sebastienb/IphoneDuoCase/build/shellA_camera_half.stl

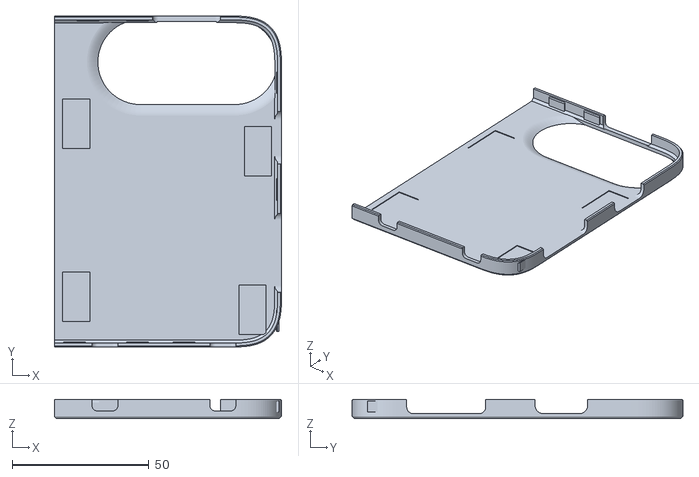
[picture p1: CAD file, 2026-11-08]
build/shellA_camera_half.stl
83.0 x 121.0 x 7.03
