sebastienb/IphoneDuoCase/build/shellB_display_half.stl

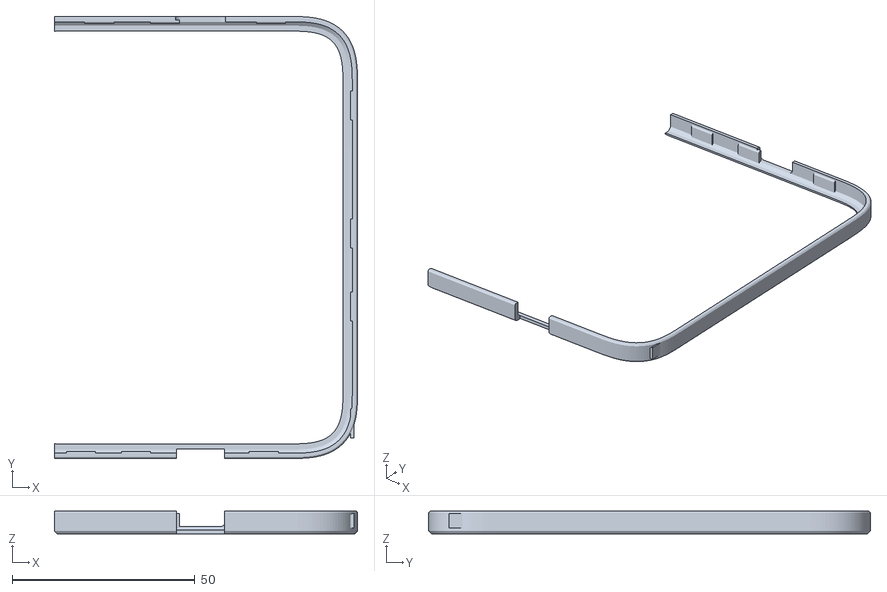
[picture p2: CAD file, 2026-11-08]
build/shellB_display_half.stl
83.0 x 121.0 x 6.23
