sebastienb/IphoneDuoCase/build/couponB_bottom.stl

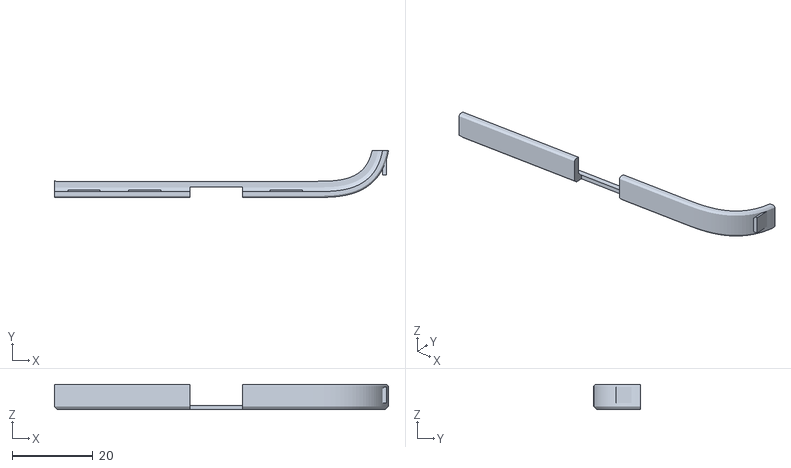
[picture p3: CAD file, 2026-11-08]
build/couponB_bottom.stl
82.6 x 11.6 x 6.23
