sebastienb/IphoneDuoCase/build/couponA_camera_top.stl

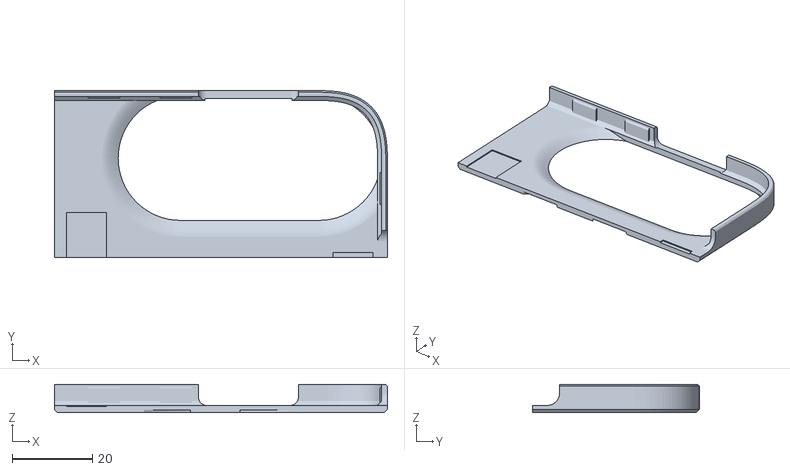
[picture p4: CAD file, 2026-11-08]
build/couponA_camera_top.stl
83.0 x 41.6 x 7.03
