sebastienb/IphoneDuoCase/build/couponA_bottom.stl

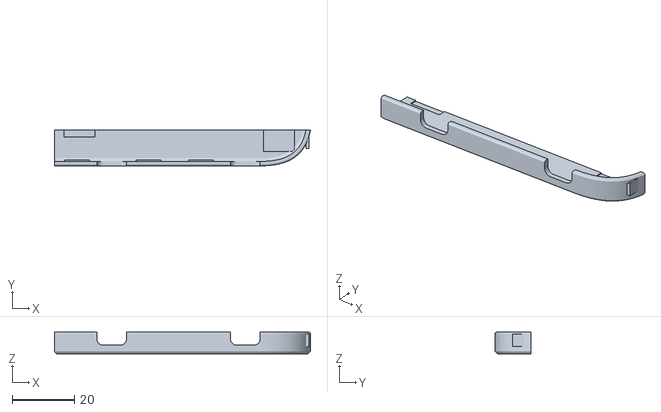
[picture p5: CAD file, 2026-11-08]
build/couponA_bottom.stl
82.6 x 11.6 x 7.03
