sebastienb/IphoneDuoCase/build/shellA_camera_collar.stl

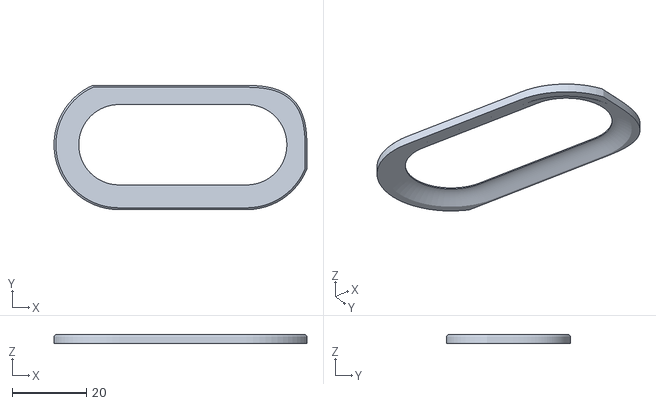
[picture p6: CAD file, 2026-11-08]
build/shellA_camera_collar.stl
68.4 x 33.6 x 2.44
