sebastienb/IphoneDuoCase/(list of files, cad)

Other CAD files:
build/duo_case.blend
