sebastienb/IphoneDuoCase/build/render_back.png

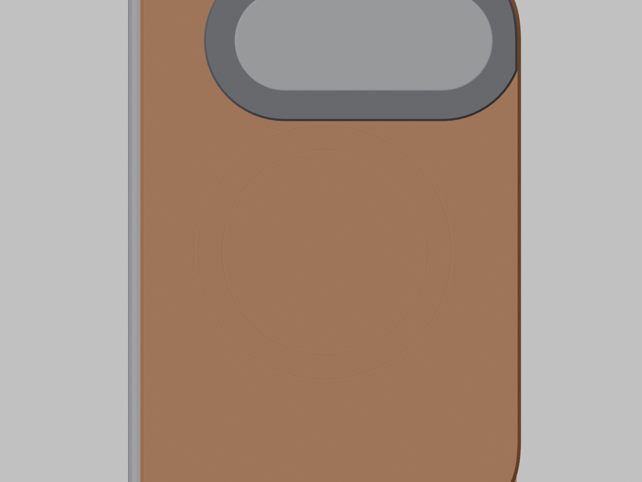
build/render_back.png
