sebastienb/IphoneDuoCase/build/render_camera_closeup.png

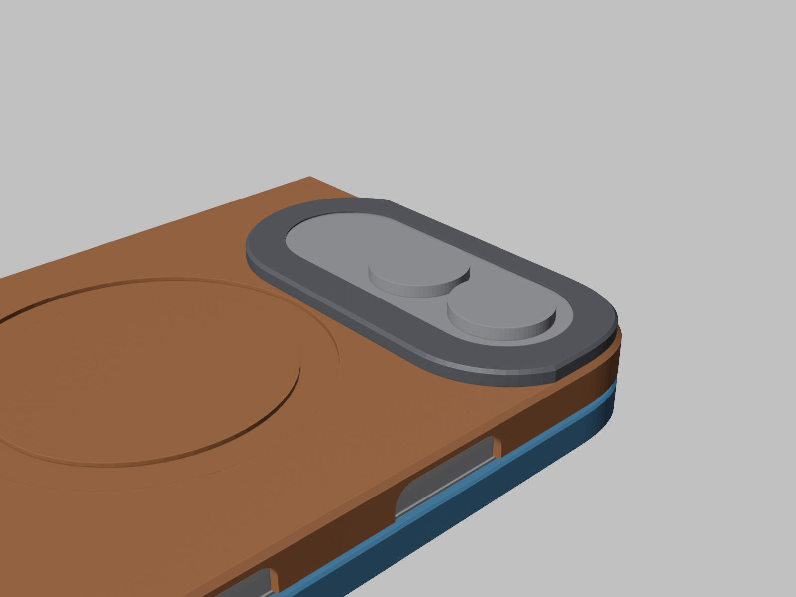
build/render_camera_closeup.png
