sebastienb/IphoneDuoCase/build/render_inside_A.png

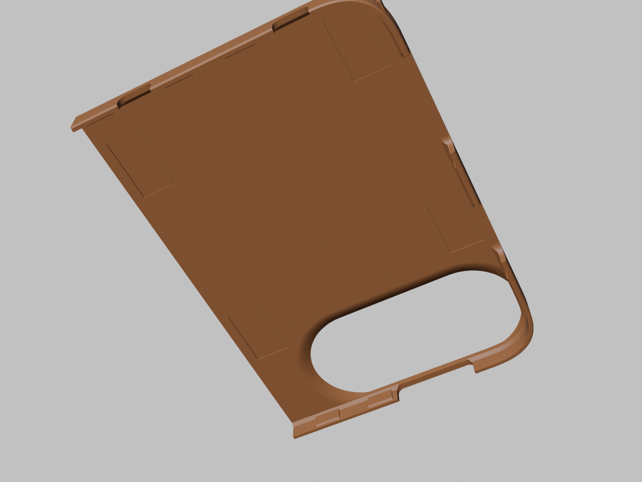
build/render_inside_A.png
