sebastienb/IphoneDuoCase/build/render_iso_back.png

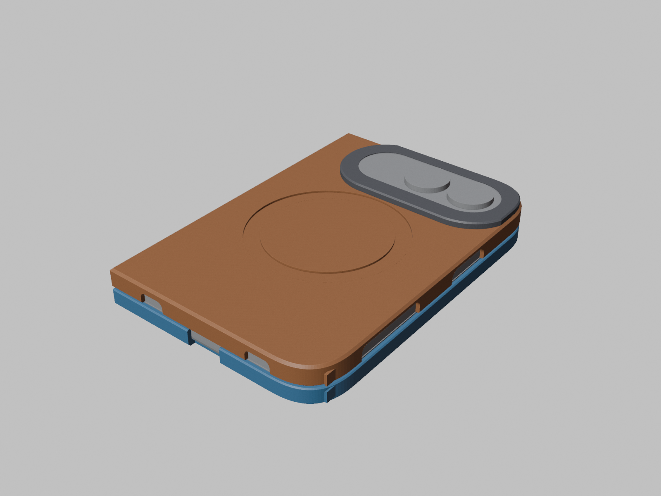
build/render_iso_back.png
