sebastienb/IphoneDuoCase/build/render_iso_front.png

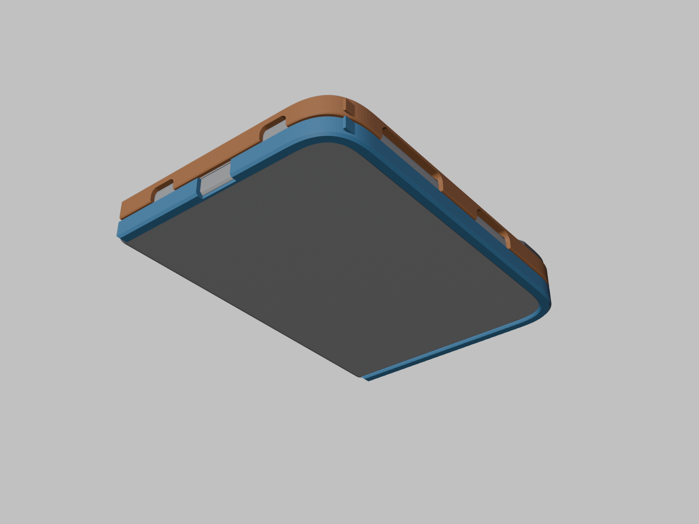
build/render_iso_front.png
