sebastienb/IphoneDuoCase/build/section_camera.png

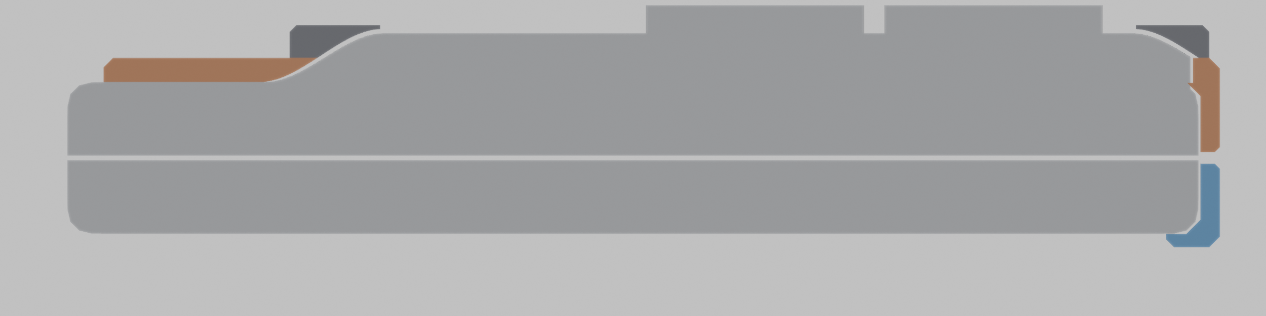
build/section_camera.png
