sebastienb/IphoneDuoCase/build/section_magsafe.png

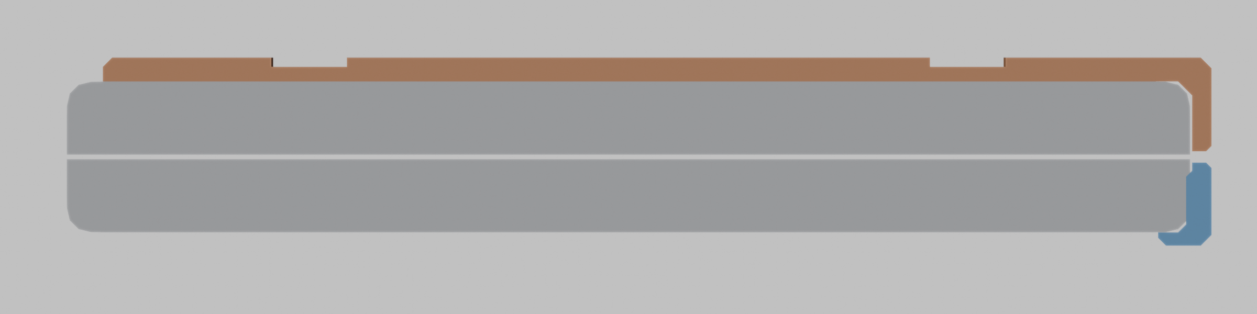
build/section_magsafe.png
