sebastienb/IphoneDuoCase/build/section_ramp.png

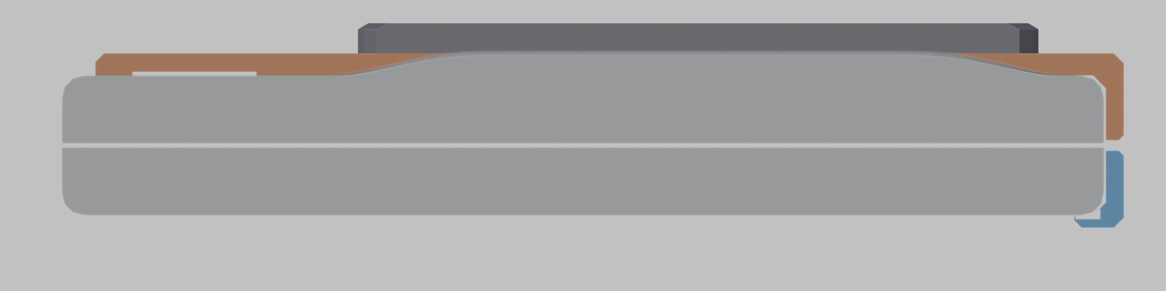
build/section_ramp.png
