sebastienb/IphoneDuoCase/build/section_usb_c.png

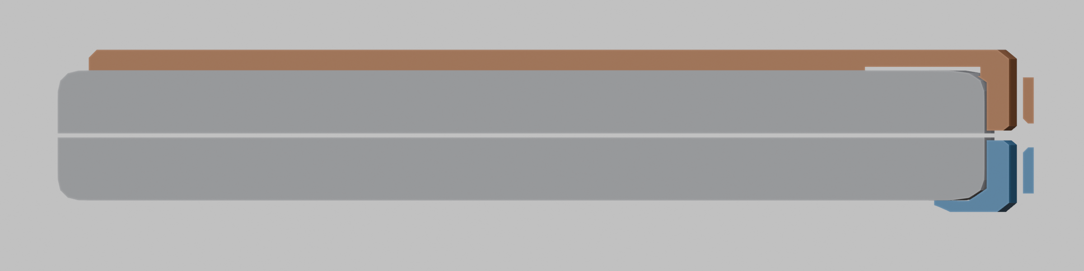
build/section_usb_c.png
