sebastienb/IphoneDuoCase/(commit log)

2026-11-08 Add iPhone Duo PLA case: parametric Blender generator, specs and research
    - case/duo_case.py builds both shells from Apple's dimensional drawing and
    exports print-ready STLs, fit coupons, renders and cross-sections
    - research/iphone-duo-specs.md: every dimension a case needs, with sources
    - research/case-design-inspiration.md: market survey and design principles
    - build/: generated STLs, .blend assembly and renders
    [couponA_bottom.stl, couponA_camera_top.stl, couponB_bottom.stl, duo_case.blend, shellA_camera_half.stl, shellB_display_half.stl]
2026-11-08 v2: ramped camera opening + glue-on collar, rounded notches, MagSafe ring recess and grip ribs
    Apple's plateau outline I used was the blend toe; the flat top is 55.6 x 21.1. The floor is now
    ramped to follow the blend so the opening hugs the plateau where it is 1.8 high, and a separate
    collar covers the slope. Speaker/button notches are rounded. Retention: MagSafe ring recess,
    0.25 mm grip ribs, tape pockets.
    [camera_ring.stl, couponA_bottom.stl, couponA_camera_top.stl, couponB_bottom.stl, duo_case.blend, shellA_camera_half.stl, shellB_display_half.stl]
2026-11-08 Size MagSafe ring recess to a 55/45/0.6 ring sticker (0.3 mm clearance, 0.7 deep)
    [couponA_camera_top.stl, duo_case.blend, shellA_camera_half.stl]
2026-11-08 Fix volume slot (Apple dims are button centres), centre receiver slot, 0.3 mm rib interference, rename collar
    [couponA_bottom.stl, couponA_camera_top.stl, couponB_bottom.stl, duo_case.blend, shellA_camera_collar.stl, shellA_camera_half.stl, shellB_display_half.stl]
